sinara-hw/Kasli-SOC/README.md

# Kasli-SOC
Xilinx ZynQ(R)  version of Kasli FPGA controller.

## Design Files

Design files (schematics, PCB layouts, BOMs) can be found at [Kasli-SOC/Releases](https://github.com/sinara-hw/Kasli-SOC/releases).

## Wiki

More information can be found on the [wiki](https://github.com/sinara-hw/Kasli-SOC/wiki).
