sinara-hw/Kasli-SOC/(threads)

Thread 1 (2018-12-02):

Zynq Kasli

dtcallcock, 2018-12-02:
A new Kasli based on the forthcoming v1.2 design, but with a Zynq-7000 series FPGA (2x ARM CPU) instead of an Artix-7 (no hard CPU).

This will allow the proposed [Zynq version of Artiq](https://github.com/m-labs/artiq/issues/1167) to utilise the EEM hardware.

The proposed FPGA is the XC7Z030-3FFG676I.  The reasons for choosing this FPGA (as laid out by @hartytp) are:
- Very similar (same Kintex-7 fabric) to the XC7Z045 FFG900 –2 used on the [Xilinx ZX706 Evaluation Kit](https://www.xilinx.com/products/boards-and-kits/ek-z7-zc706-g.html) that will likely be used for gateware development.
- The CPUs on the 7Z030 go up to maximum 1GHz clock rate available on 7000 series Zynqs.
- Fastest speed grade to ensure we can clock the AXI bus as fast as possible. The thought is that cost sensitive users can stick with the Artix Kasli, and the main user base for Zynq Kasli will be people who don’t mind paying an extra $50 to get the fastest FPGA.
- The design costs + risks will be much lower if we use a Zync model that @gkasprow has used in previous designs. He's used this FPGA before.
- It has enough pins to drive all 12 EEM connectors + WR oscillators

SDRAM would be routed to the ARM subsystem only.  The gateware will still have DMA access based on tests carried out by @cjbe, where he found that:

> I have tested DMA from PL to PS-SDRAM via the HP ports, and indeed it works without any problems, and one gets the advertised bandwidth.

I am working on getting this board funded and would appreciate any input.

Also, is 'Zynq Kasli' a confusing name?  Do we need to dust off our Russian maps and come up with something more unique?

gkasprow, 2019-12-08:
My student will take care of this board very soon. He will post new issues so don't be surprised.

hartytp, 2019-12-29:
XC7Z030-3FFG676 sounds like a good choice for this.

As mentioned before, I'd ideally like to go for 4 SPF + 1 RJ45 on the front panel, copying ethernet from the zc706.

Ram to the PS only.

Other than that, stick as close to the current Kasli 2.0 design as possible.

gkasprow, 2020-01-06:
The schematics are close to completion.
Btw, @sbourdeauducq did you see [this](https://www.electronicproducts.com/Digital_ICs/SoCs_ASICs_ASSPs_MEMS/Microchip_offers_early_access_to_PolarFire_SoC_FPGA.aspx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)

sbourdeauducq, 2020-05-05:
>     * no SD Card

We want a SD card if possible. From experience on ZC706, it might be the least troublesome way to get non-volatile storage on Zynq, and there's the easy "escape hatch" of extracting the SD card and putting it into a $5 USB adapter in case Zynq won't write to it. The PS NOR flash controller is messed up; the only thing that seems to work semi-reliably is a read-only mode where the flash contents are mapped into the CPU memory. We didn't manage to write to the flash at all. There may be some workarounds in some cases like re-routing the flash to GPIO and bit-banging, but it's extra trouble and development time.

filipswit, 2020-05-07:
I'll try to fit it. It looks there is enough space above RAM but only for this kind of socket: https://www.molex.com/molex/products/part-detail/memory_card_socket/0473092651

The white line is the outline of microSD
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

gkasprow, 2020-05-07:
I used a slightly higher version of this Molex connector and managed to fit the BGA chip under the SD card. You can use it as well and rotate the connector if that helps.

sbourdeauducq, 2020-05-08:
How well does this connector hold the SD card?
We'll want to ship systems with the SD card pre-installed, and carriers sometimes handle packages roughly - while they have teams whose job is to find excuses to deny claims. And just normal transportation vibrations tend to dislodge things. So our hardware should be pretty sturdy.

gkasprow, 2020-05-09:
We used these connectors in the production of 8k pieces of LTE routers. There were several issues with these boards but it never happened that SD slipped off.
Here are some photos
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

gkasprow, 2020-05-09:
We used these connectors in the production of 8k pieces of LTE routers. There were several issues with these boards but it never happened that SD slipped off.
Here are some photos
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

jordens, 2020-05-09:
They have the standard spring loaded ratchet locking mechanism, right? There is no way they'd fall out. Get proper packaging and tie down cables properly and make sure fasteners designs are right and tightened properly.

filipswit, 2020-05-16:
Version with SD card is on a repo.

Closed 2020-05-29.

Thread 2 (2020-01-08):

Specification of the module - protection diodes

filipswit, 2020-01-08:
What about protection diodes, about which @gkasprow was recalling in https://github.com/sinara-hw/Kasli-SOC/issues/1#issuecomment-443714668. Should I add them?

gkasprow, 2020-01-08:
No, they are not needed because we assume that modules were already tested prior shipment.

Closed 2020-01-18.

Thread 3 (2020-01-11):

Zynq reset/JTAG fiasco

sbourdeauducq, 2020-01-11:
The Zynq reset and JTAG interface is complicated and temperamental, and in particular we observed the following problems:
* It requires a SRST signal controlled by the JTAG adapter. This signal is a bad idea as reset commands could be delivered over JTAG just fine without the various complications associated with an additional signal. This is apparently done by ARM for power consumption reasons (keep JTAG powered down until the first SRST), but a much better design would have been a level-sensitive "JTAG enable" pin that could be tied high with a jumper in hardware. (In Xilinx's defense, this is a mistake that ARM made)
* A pulse on SRST that is too short makes the ARM cores fall off the JTAG chain (they disappear even if they had been detected just before the short pulse), sometimes until the Zynq chip is power cycled.
* Attempting to use ARM JTAG while one of the ARM cores is stopped breaks the JTAG interface, again, sometimes until a power cycle. Note that stopping an ARM core can be done in firmware; in other words, Zynq is designed in a way that using JTAG at the wrong time depending on what the firmware is doing can put JTAG in an unrecoverable state.

There is a "PS_POR_B" input on Zynq that may or may not be used in lieu of a power cycle. [The technical reference manual says](https://www.xilinx.com/support/documentation/user_guides/ug585-Zynq-7000-TRM.pdf) "This signal resets every register in the device capable of being reset". Trust but verify...

I propose:
* Be very careful about SRST and POR signals on this board. Maybe expose the traces when routing in a way that the board can be easily manually reworked in case of problems.
* Make POR accessible to the debug computer. Putting it on a GPIO expander accessible on one of the I2C buses connected to a FTDI channel sounds like a good idea to me because 1) this FTDI/I2C system worked fine on Kasli 2) we are not exposed to FTDI GPIO problems 3) it makes it harder to accidentally trigger a POR e.g. by using the wrong driver on that FTDI channel.
* Do careful experimentation with POR: put the Zynq into "JTAG broken" states and check that it can always recover with a POR. This can be done on the ZC706 which has POR control on a pushbutton.
* If it turns out that POR doesn't work as documented or if we still don't trust it, also make the Zynq power supply control accessible on I2C.

filipswit, 2020-01-22:
I changed the power sequencing system - https://github.com/sinara-hw/Kasli-SOC/issues/4
So the power supply system should just work.
Now the POR is controlled by supervisor IC and eventually by GPIO. SRST is normally pulled high (unused), optionally you can drive it from GPIO.  Of course during the layout I'll try to put all these traces on external layers.

sbourdeauducq, 2020-01-23:
> SRST is normally pulled high (unused), optionally you can drive it from GPIO.

That's not optional. We **need** to be able to drive it from the JTAG adapter, and to avoid further complications, the SRST layout and polarity must match those of existing common JTAG adapters.

filipswit, 2020-01-26:
Ok. Default mounting will allow it.

Closed 2020-05-29.

Thread 12 (2020-01-12):

add Ethernet chip

gkasprow, 2020-01-12:
add the Marvell Ethernet chip as on ZC706 devkit. It is in CERN lib. It was also used in MARBLE AMC FMC design. It is connected to SoC using RGMII

gkasprow, 2020-01-12:
copy pinout from  ZC706

gkasprow, 2020-01-12:
and add connector with magnetics.

gkasprow, 2020-01-15:
Please use verified schematic from Marble board
https://github.com/BerkeleyLab/Marble

filipswit, 2020-01-22:
Added.
BTW It looks like in Marble is a small bug. VDDO_SEL should be tied low for 2.5V operaion.

Closed 2020-01-22.

Thread 14 (2020-01-12):

IC12 not needed

gkasprow, 2020-01-12:
we have 2V5 on both sides of it

filipswit, 2020-01-18:
'Main_DCXO_OE' and 'Helper_DCXO_OE' are driven from  I2C_expanders -IC24, IC25 (3V3), same as on Kasli. I didn't route it to Zynq just to make as less changes as possible.

Closed 2020-01-19.

Thread 16 (2020-01-12):

missing VREF_DDR and VTT_DDR regulator

gkasprow, 2020-01-12:

Closed 2020-01-18.

Thread 17 (2020-01-12):

use E24 RC

gkasprow, 2020-01-12:
Try to use E24-series RC: DDR termination can be 39R,
LDO and SMPS FB resistors can be calculated out of E24 using [this tool](http://mustcalculate.com/electronics/automaticresistivevoltagedivider.php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)
this limits the BOM count

filipswit, 2020-01-22:
Ok.

Closed 2020-01-22.

Thread 5 (2020-01-12):

TPS7A7200RGW

gkasprow, 2020-01-12:
is there any reason why external divider is used instead of configuration pins?

filipswit, 2020-01-18:
Well..it is easier to adjust voltage after production, but I can change it to configuration pins.

gkasprow, 2020-01-18:
can we have both options? With 0R resistor for example...Once we decide that voltage is OK, we remove feedback resistors

filipswit, 2020-01-18:
Yes. It is more spacious option but it is fine. I just realized that it is probably easier to put 0R to all configuration pins and in case of adjusting add or remove jumper, and it will be with 50 mV accuracy.

gkasprow, 2020-01-19:
in such case just leave as it is.

Closed 2020-01-19.

Thread 6 (2020-01-12):

power budget missing

gkasprow, 2020-01-12:
please add power budget. Use [ADI tool ](https://www.analog.com/en/design-center/design-tools-and-calculators/power-management-tools.html)

filipswit, 2020-01-22:
Added.

Closed 2020-05-29.

Thread 9 (2020-01-12):

P3V3REG

gkasprow, 2020-01-12:
why we have two 3V3 rails?

gkasprow, 2020-01-12:
I assume it is just for the power sequencer chip...

filipswit, 2020-01-19:
Yes, It was for power sequencer, since we not use sequencer it is not needed anymore.

Closed 2020-01-19.

Thread 20 (2020-01-26):

Ethernet connector placement

filipswit, 2020-01-26:
Should it be on front panel? It will cause some changes in SMAin and USB placement.

gkasprow, 2020-01-26:
sure. Not a problem at all. Panel is the easiest part.

Closed 2020-05-29.

Thread 21 (2020-01-29):

Memory bus width

dhslichter, 2020-01-29:
Previous issues with DMA slowness on Kasli (https://github.com/m-labs/artiq/issues/946) suggest that it would be helpful to make the memory bus wider.  If Kasli-SOC is to be a higher-performance sibling of Kasli, it seems we should think about a wider memory bus (more like KC705)?

filipswit, 2020-02-08:
Not sure what we can do with it. On KC705 bus is x64. In Kasli-SOC we connect RAM to PS only, so we have x32.

Closed 2020-05-29.

Thread 22 (2020-04-22):

PCB review

gkasprow, 2020-04-22:
- [x] separate SMPS from oscillators on top layer. The current from SMPS flows through the R40
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. It's better to use diamond-type copper balancing on top and bottom.
- [x] remove acute angles
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
- [x] use symmetrical amount of copper on component pads. Either use thermals on both vias or solid copper on both pads.
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
- [x] GTPs are too close
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
- [x] perform PI analysis in Altium, it has nice PDN tool
- [x] no need to use polygon as VREF line. It breaks the SI for DDR lines on Mid8. Single trace is good enough
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
- [x] separate the vias - now they break vertically all planes and create the loop. Simply move every second via to the right.
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
- [x] move the power plane to the left so it does not cross the MGT lines
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
- [x] add a note to the DIP switch
- [x] add FPGA heatsink 3D model
- [x] add MCX and SMA connector functions
- [x] add IC designators

Closed 2020-05-29.

Thread 23 (2020-05-10):

SDRAM reference?

sbourdeauducq, 2020-05-10:
Is the SDRAM configuration an exact copy of a Xilinx development kit, and which one?
Getting the PS SDRAM controller to work is rather difficult, so it would be good to simply reuse something that is known to work (also we could simply run the existing FSBL for a quick test of the board) and for which the correct PS register values can be looked up.

filipswit, 2020-05-15:
It's connected without any pin swapping.

sbourdeauducq, 2020-05-16:
What about the SDRAM chip P/N including timing, number of rows/columns, etc.

filipswit, 2020-05-16:
I've used: MT41K256M16TW-107:P

sbourdeauducq, 2020-05-17:
Is there a Zynq Xilinx kit with this exact chip?

filipswit, 2020-05-20:
I've found only some chinese kits: qmtech zynq7000 and Lychee HEX ZYNQ702.

sbourdeauducq, 2020-05-21:
Could we use a SDRAM system that is an exact copy of a better-known kit? Is there a reason not to?

sbourdeauducq, 2020-05-21:
For example, Cora Z7-10. Not that we have managed to get the SDRAM to behave itself on this board without the Xilinx junk libraries (we have only done so on the ZC706, on the Cora there is typical Zynq behavior) - but at least we can use the latter as a workaround.

filipswit, 2020-05-21:
Well, SDRAM from Cora -  MT41K256M16HA-125:E looks fine for me.

sbourdeauducq, 2020-05-23:
OK.

Closed 2020-05-23.

Thread 24 (2020-07-22):

HDL verification

gkasprow, 2020-07-22:
@sbourdeauducq did you look at SoC pins assignments? We want to produce it pretty soon
@filipswit did you run the SI-DDR test after routing?

filipswit, 2020-07-22:
nope, I didn't.

sbourdeauducq, 2020-07-23:
> @sbourdeauducq did you look at SoC pins assignments?

No. We are scrambling to get things to work on the ZC706 before the deadline, lots of difficult problems appeared when we tried to run non-trivial kernels.

sbourdeauducq, 2020-07-23:
Could you publish PDF schematics (we don't have Windows machines or Altium, and the online viewer is a bit unwieldy), and a machine-readable version of the FPGA pin assignments?

filipswit, 2020-07-23:
Sch:
https://github.com/sinara-hw/Kasli-SOC/tree/master/PDF

sbourdeauducq, 2020-07-23:
Thx

sbourdeauducq, 2020-07-23:
What is the purpose of the PL watchdog? The PL is generally quite well-behaved, it's the PS that is often troublesome.

sbourdeauducq, 2020-07-23:
Table on Sheet 7 says " 1 | 1 => SD Card (not on board)", but now we have a SD card.

sbourdeauducq, 2020-07-23:
Clock-capable EEM pins (indexed 0) must go to CC pins!
The clock rules on the PL are the same as regular 7-series FPGAs.

marmeladapk, 2020-07-23:
@filipswit It would be better to tag a commit and make a (preliminary) release and post PDF there. It won't clutter up the repository (which can significantly increase in size due to many binary files) as PDF is an output file not a source. We follow this approach in other Sinara repositories.

sbourdeauducq, 2020-07-23:
I suggest connecting RGMII to the PS (MIO). We have a driver for it so we might as well use it; and other Zynq code (e.g. some people love embedded Linux) also typically expects the PS Ethernet controller.
What's the idea with Ethernet anyway? Are we going to use primarily the RJ45 jack (with PS MAC) or the SFP (with transceiver and PL MAC)?

hartytp, 2020-07-23:
> What's the idea with Ethernet anyway? Are we going to use primarily the RJ45 jack (with PS MAC) or the SFP (with transceiver and PL MAC)?

I'd love to have Ethernet on the RJ45 in addition to the standard 4 SFPs.

As an example use case: it's been an ambition of ours for a while to have a feature which lets us stream out diagnostic data via ethernet. e.g. ADC traces to implement scope-like functionality. Would be great to have this on satellites while still maintaining our 3 downstream DRTIO ports.

sbourdeauducq, 2020-07-23:
I2C can go to the PS so we can autodetect the cards without any gateware programmed (@jordens might like this).
It would be fun to run yosys and prjxray on the PS and have the card build its own gateware :)

Many of the other GPIO signals currently in PL bank 13 (fan, pushbutton, error LED, maybe some of the user LEDs, etc.) can go to the PS as well, but definitely not the WRPLL I2C. The Zynq architecture is PS-centric (for better or worse, IMO mostly the latter), and the card should reflect that.

Note: if we need to free resources, the QSPI NOR flash can go. The SD card works well here (both r+w) and we don't currently plan to use the flash at all.

gkasprow, 2020-07-23:
@filipswit Moreover, EEMx signals should be in the same bank. Remember when changing CC pins assignments.

sbourdeauducq, 2020-07-23:
Why do we have an EEPROM (IC8) with a dedicated I2C bus?
Do we need the DS2411R identifier device when we can get I2C EEPROMs with a unique ID burned in instead?

gkasprow, 2020-07-23:
@sbourdeauducq Ethernet is routed to PL for flexibility. The embedded MAC can talk to it via EMIO easily.

gkasprow, 2020-07-23:
I2C goes to PL for flexibility. We had issues with PS I2C reliability and had to use IPcore instead. But it was an issue with early silicon versions.

sbourdeauducq, 2020-07-23:
> Ethernet is routed to PL for flexibility. The embedded MAC can talk to it via EMIO easily.

It's more a compromise than "flexibility": This requires the gateware to be programmed for Ethernet to work, and then we cannot download gateware from the network during boot, for example.
Also, I am worried about timing issues with the gateware routing delays between EMIO and PL I/O pins.

> We had issues with PS I2C reliability

PS peripherals are generally garbage indeed, but in the case of I2C I think we can use the MIO in GPIO mode and bit-bang from software. That should work around the idiocy built into the PS I2C controller. If you're worried we could demonstrate that on a devkit.

sbourdeauducq, 2020-07-23:
I'm a little skeptical of the analog hack that involves AC coupling of the fan PWM signal. Has this been tested before?

sbourdeauducq, 2020-07-23:
Don't we have the same I2C bug with the FTDI chip that caused contention on Kasli v2?

sbourdeauducq, 2020-07-23:
The SRST signal ***absolutely*** needs to go on the FTDI chip GPIO directly, with a configuration that is ***strictly identical to a known-good programming adapter***. Controlling it via FTDI I2C, switches and expanders in OpenOCD (or worse, Vivado, which already crashes every 15min when connected to a Zynq device) will be an absolute disaster and result in insane levels of frustration.

For example, SRST control mostly works with the Olimex ARM-USB-TINY-H, but I could not get it to work with the internal JTAG module of the ZC706.

Note that even with SRST control, there are still plenty of PS JTAG bugs and weird hardware states that require a power cycle to get out of.

sbourdeauducq, 2020-07-23:
And, someone should check, but I think that if you do not send a SRST *pulse* (constant level is not sufficient) then the ARM cores do not appear on the JTAG chain, only the PL does. So this signal is really important.

sbourdeauducq, 2020-07-23:
SRST also needs to be exposed on J8.

sbourdeauducq, 2020-07-23:
Nitpick: do we need a "general purpose pushbutton"? Kasli doesn't have one and there's no use case for it AFAIK.

sbourdeauducq, 2020-07-23:
> As an example use case: it's been an ambition of ours for a while to have a feature which lets us stream out diagnostic data via ethernet. e.g. ADC traces to implement scope-like functionality. Would be great to have this on satellites while still maintaining our 3 downstream DRTIO ports.

What about using the DRTIO aux channel for this?

hartytp, 2020-07-23:
> What about using the DRTIO aux channel for this?

@dnadlinger but I believe the idea was to keep things distributed to avoid bottlenecks of doing everything through the master

dnadlinger, 2020-07-23:
I recently discussed this with @pmldrmota, as he is looking into this with our summer student Miray. Basically, using the aux channel would be the preferred solution if we can get the "relay" bandwidth on the root of the tree, i.e. the core device, high enough (some dozen Mb/s to Ethernet) without interfering with kernel RPCs too much.

If that turns out to be hard (which it might well on or1k), putting Ethernet on the satellites would be a "scalable" fallback option.

filipswit, 2020-07-26:
> What is the purpose of the PL watchdog? The PL is generally quite well-behaved, it's the PS that is often troublesome.

I can remove it or connect to PS

> Do we need the DS2411R identifier device when we can get I2C EEPROMs with a unique ID burned in instead?

I can remove it

> I'm a little skeptical of the analog hack that involves AC coupling of the fan PWM signal. Has this been tested before?

It's a copy from Kasli, so I assume it works.

> Don't we have the same I2C bug with the FTDI chip that caused contention on Kasli v2?

What kind of bug?

> he SRST signal absolutely needs to go on the FTDI chip GPIO directly,

Ok will swap it from I2C expander to FTDI GPIO.

> Nitpick: do we need a "general purpose pushbutton"? Kasli doesn't have one and there's no use case for it AFAIK.

I thought might be useful. Will be removed.

sbourdeauducq, 2020-07-26:
> > What is the purpose of the PL watchdog? The PL is generally quite well-behaved, it's the PS that is often troublesome.
>
> I can remove it or connect to PS

There are some PS states which are unrecoverable without a power cycle (they include JTAG breakage). I don't know if using the POR signal instead of a power cycle would work. Maybe it is worth keeping the watchdog as an option that can pulse POR, with an easy option to disable it (e.g. jumper or solder bridge) so it does not get in the way of early development and/or can be permanently disabled if it causes trouble.
Also, keep in mind that loading a program into the Zynq from JTAG (PS+PL) takes dozens of seconds during which the Zynq chip is frozen, and if you pulse POR during that time then it won't work. Booting it from the SD card is also not instantaneous, and a POR pulse will interrupt the boot process. Any watchdog circuit must be designed accordingly.

> > Do we need the DS2411R identifier device when we can get I2C EEPROMs with a unique ID burned in instead?
>
> I can remove it

OK.

> > I'm a little skeptical of the analog hack that involves AC coupling of the fan PWM signal. Has this been tested before?
>
> It's a copy from Kasli, so I assume it works.

AFAIK nobody tested it.

> > Don't we have the same I2C bug with the FTDI chip that caused contention on Kasli v2?
>
> What kind of bug?

https://github.com/sinara-hw/Kasli/issues/78

> > he SRST signal absolutely needs to go on the FTDI chip GPIO directly,
>
> Ok will swap it from I2C expander to FTDI GPIO.

Make sure this matches a layout that OpenOCD and - if possible - Vivado already supports.

marmeladapk, 2020-07-26:
> AFAIK nobody tested it.

We tested it at CTI during Kasli v2.0 tests. It works fine.

niedz., 26 lip 2020, 13:10 użytkownik Sébastien Bourdeauducq <
notifications@github.com> napisał:

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

filipswit, 2020-08-03:
Schematics and actual pin assignment:

[Kasli-SOC.PDF](https://github.com/sinara-hw/Kasli-SOC/files/5018408/Kasli-SOC.PDF)

[Kasli-SOC.zip](https://github.com/sinara-hw/Kasli-SOC/files/5018413/Kasli-SOC.zip)

sbourdeauducq, 2020-08-04:
Which OpenOCD cable file should I use to set up SRST?

sbourdeauducq, 2020-08-04:
How is the watchdog getting disabled during JTAG programming (which takes more than 700ms)?
The POR pulse does not need to be as long as 1s.
What is the purpose of C75? Glitch filtering? I wonder if slow rising edges on POR_B are good. And glitch filtering may not be necessary. The TRM states: "The PS_POR_B reset pin is held Low until all PS power supplies are at their required voltage levels and PS_CLK is active. It can be asynchronously asserted and is internally synchronized and filtered. The  filter prevents High-going glitches from entering the PS while the signal is intended to be held Low. It does not filter Low-going glitches when the signal is intended to be held high. Any Low-going glitch that is detected causes an immediate reset of the device."

If there are too many issues with this watchdog chip and associated circuitry (IC29A, IC29B, C75...), we might as well remove them, simply keeping IC30. Also, remove PB2 (oftentimes, ARTIQ boards are used remotely without physical access to pushbuttons) and connect I2C_exp_POR to MR# of IC30.

I suggest connecting I2C_exp_POR to a FTDI GPIO directly. The Zynq may lock up the I2C bus (all it takes is holding SCL or SDA low), which is a common situation, and then we can't POR it to recover control.
Considering the state of FTDI chips and associated software, this requires careful prior testing:
* the GPIO is actually working with the FTDI chip configured as intended on this board (JTAG, I2C, UART)
* toggling the GPIO does not break JTAG, UART, or I2C. FTDI GPIO controllers are extremely buggy and there are lots of surprises like that.
* using OpenOCD with default cable files does not trigger POR
* plugging the USB cable with the default (UART) driver attaching does not trigger POR

IC30 is only monitoring 3.3V, and 3.3V comes before VCCDDR according to the table on page 14. Isn't VCCDDR a PS supply?

I still think more signals should be routed to the MIO instead of the PL, in particular the RGMII ones where timing is critical and where we may want to boot from the network including the PL. PL Ethernet, if required, can still be done with SFP and transceiver. Also, have you copied *exactly* the Ethernet circuit of a devkit? Is the PHY functional immediately after power up without having to fiddle with MDIO?

What is the idea with the "internal" I2C bus?

filipswit, 2020-08-04:
When we connect PS_POR to IC30 MR#, we can skip IC29 and simplify it a little.

Is there any difference to which FTDI output I connect PS_POR?

From UG: "The PS_POR_B input is required to be asserted to GND during the power-on sequence
until VCCPINT, VCCPAUX and VCCO_MIO0 have reached minimum operating levels" so P3V3 is last rising PS supply.

Actually I can connect tems sensors to SHARED_I2C. IC8 can be removed as well, I just havent noticed there is IC5 eeprom on MUX sheet.

sbourdeauducq, 2020-08-05:
> Is there any difference to which FTDI output I connect PS_POR?

As long as the four tests above are OK, no.

sbourdeauducq, 2020-08-07:
> PS peripherals are generally garbage indeed, but in the case of I2C I think we can use the MIO in GPIO mode and bit-bang from software.

It works:
https://git.m-labs.hk/M-Labs/zynq-rs/pulls/58

Please connect I2C (and other things) to the PS. As long as there is no case for gateware acceleration/control, things should go to the PS by default.

filipswit, 2020-08-12:
I made above changes. @sbourdeauducq I2C and interrupts, and switch reset are routed to PS now.
Below are actual sch and pin assignment. If everything is fine, during weekend I will put final layout on repo.
[Kasli-SOC.zip](https://github.com/sinara-hw/Kasli-SOC/files/5065510/Kasli-SOC.zip)

[Kasli-SOC.PDF](https://github.com/sinara-hw/Kasli-SOC/files/5065494/Kasli-SOC.PDF)

sbourdeauducq, 2020-08-13:
> Which OpenOCD cable file should I use to set up SRST?

What about this question?

>  Considering the state of FTDI chips and associated software, this requires careful prior testing:

Have you done these tests?

RGMII should still go to the PS.

I also recommend connecting at least LED_ERR to the PS so that errors that occur before PL startup can be reported on the front panel as well.

Should there be pullups on I2C_SW_RESET so that the I2C switches are automatically reset when the Zynq is reset (please check if a simple pullup resistor would work: timing, state of MIO during reset)? Then the other I2C_SW_RESET line to the FTDI chip can perhaps be removed, since we could POR the Zynq to recover from a stuck I2C bus situation.

filipswit, 2020-08-14:
> Which OpenOCD cable file should I use to set up SRST?

Sorry I've never used OpenOCD. I cant figure what are 'cable files'.

I connected it with this connecion list:
− RXD(5) - TDI
− TXD(1) - TCK
− RTS(3) - TDO
− CTS(11) - TMS
− DTR(2) - TRST
− DCD(10) - SRST

from http://openocd.org/doc/pdf/openocd.pdf

> Considering the state of FTDI chips and associated software, this requires careful prior testing:

Have you done these tests?

I don't have possibilities to make these tests.

> Should there be pullups on I2C_SW_RESET so that the I2C switches are automatically reset when the Zynq is reset (please check if a simple pullup resistor would work: timing, state of MIO during reset)? Then the other I2C_SW_RESET line to the FTDI chip can perhaps be removed, since we could POR the Zynq to recover from a stuck I2C bus situation.

I will add PU/PD with default mounted PU and leave I2C_SW_RESET line to the FTDI as is, when will be not needed will mark it as not mounted in future.

Because we connect Ethernet to PS, it will cause some more layout rework with LVDS and supplies and probabbly something more. @sbourdeauducq so now, I can connect some more stuff to PS, could you please point which exactly signals you would like to be conneccted to PS instead of PL.

sbourdeauducq, 2020-08-15:
> Sorry I've never used OpenOCD. I cant figure what are 'cable files'.

> I don't have possibilities to make these tests.

Someone ought to figure this out, study it in detail, and run the tests carefully before board fabrication. Both the FTDI chip and the Zynq JTAG/reset interface are obnoxious crap, which, combined together, really have a lot of potential for frustrating problems if we are not very careful.
Vivado support is also desirable, if possible at all without breaking OpenOCD. For example the built-in JTAG adapter of ZC706 works with Vivado as far as Zynq stuff works with Vivado, but is very unreliable with OpenOCD due to obscure SRST-related problems. It may be a good idea to have someone spend time on understanding why this is the case. I just wanted to my code to run so I used an external Olimex cable instead (incompatible with Vivado), and "only" spent two days on this problem.
I do not currently have more time for these onerous tasks, but not doing it right now is just kicking the can down the road and making the problem worse since it will then involve PCB rework and/or fabrication of adapters to connect external JTAG cables to the broken internal programming system. If you want to go that route, please make the JTAG, POR, and SRST signals easy to disconnect and rewire to an external adapter (for JTAG and SRST, ARM-USB-TINY-H works mostly correctly on ZC706).

> Because we connect Ethernet to PS, it will cause some more layout rework with LVDS and supplies and probabbly something more.

If you want some simplification you can drop both SPI flash chips - we don't plan to use it, the SD card does the job.

> @sbourdeauducq so now, I can connect some more stuff to PS, could you please point which exactly signals you would like to be conneccted to PS instead of PL.

* I2C (except WRPLL): definitely PS
* GPIO_INTx, I2C_SW_RESET: same as above
* RGMII, MDIO, PHY_RSTn: definitely PS
* Fan PWM: not sure about this one since I don't know if the PS PWM controller works correctly (if I did I would say move to PS), and wasting CPU cycles on toggling the fan GPIO sounds annoying. Maybe just leave it to PL.
* DDBUS: good idea to leave on PL since we can use it e.g. with Microscope, but maybe rename it to UART_PL (and the other one UART_PS).
* LEDs: ERROR LED should go to PS as I said, for LEDs in general maybe a mix of PS/PL is good since LEDs are sometimes useful to debug/test simple gateware.

Why are there still two general purpose I2C buses (SDA_int/SCL_int and I2C_2V5_SW_SDA/I2C_2V5_SW_SCL)?

sbourdeauducq, 2020-08-29:
Are you leaving the 1-wire ID thing? It's still on the latest schematics.

gkasprow, 2020-08-29:
The less various interfaces the better. More useful are ID chips with MAC address

filipswit, 2020-08-29:
@sbourdeauducq  are you sure you are watching the latest files?

sbourdeauducq, 2020-08-29:
No, my mistake. But please remove https://github.com/sinara-hw/Kasli-SOC/tree/master/PDF

filipswit, 2020-08-29:
I will do it with next repo update.

filipswit, 2020-09-20:
SPI Flash was removed due to routing problems.
I added 2.54 mm jumper for POR and SRST signals. I hope that this will be fine for debugging.
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

[Kasli-SOC.PDF](https://github.com/sinara-hw/Kasli-SOC/files/5251952/Kasli-SOC.PDF)

[Kasli-SOC_20200920.zip](https://github.com/sinara-hw/Kasli-SOC/files/5251953/Kasli-SOC_20200920.zip)

sbourdeauducq, 2020-09-21:
For POR I would put the jumper *before* the supervisory IC. The manual is clear that POR should be asserted until supplies are stable, so removing the jumper would otherwise always cause problems.

The issue with these signals really comes from:
1. crappy FTDI chips
2. crappy drivers
3. crappy JTAG software
4. [stupid attitude from Xilinx](https://www.xilinx.com/support/answers/68889.html)

sbourdeauducq, 2020-09-30:
Anyway, this solution forgoes Vivado hardware manager support. Only dissecting Xilinx/Digilent adapters for supported POR/SRST configurations, putting a Xilinx compatible JTAG header, or putting one of those silly Digilent FTDI modules would enable it.
I hate Vivado and the current solution with probably-working FTDI GPIOs and jumpers for easy debugging/workarounds would be somewhat okay with me personally, but it will cause problems if you/others want to develop with the official Xilinx toolflow.

sbourdeauducq, 2020-09-30:
If I understand correctly, the IC42 inverter would fix the equivalent of https://github.com/sinara-hw/Kasli/issues/78.
I'm still not a fan of multimastering I2C and would prefer a "I2C proxy firmware" that talks over UART (that's easily developed, and loaded by JTAG into the Zynq OCM). Do we keep the FTDI-I2C at all (@jordens)?

jordens, 2020-09-30:
Yes

hartytp, 2020-09-30:
@sbourdeauducq can we move this to its own issue to make following the conversation easier?

> Do we keep the FTDI-I2C at all (@jordens)?

The USB-I2C interface provides useful functionality which I'd be sad to loose. What would you replace it with? Assuming the issue is now fixed on Kasli, I struggle to see a good reason (i.e. not just aesthetics) to throw that away.

sbourdeauducq, 2020-09-30:
As I mentioned: replace it with a I2C proxy firmware.
The hardware does not have problems but the ARTIQ I2C firmware implementation does not support multimastering, and likely other implementations such as libftdi do not support it well either. Multimastering is complex and fragile and implementing it correctly is harder than loading proxy firmware/gateware.
You will hit bugs if you try to access the I2C bus while ARTIQ is running and attempting to use it at the same time.

sbourdeauducq, 2020-09-30:
Anyway as long as the hardware doesn't have problems, I don't really care about this issue, and we can always DNP the related components later.

sbourdeauducq, 2021-02-16:
We have firmware now:
https://nixbld.m-labs.hk/build/129246
https://git.m-labs.hk/M-Labs/artiq-zynq/src/branch/master/demo.json
(Still a few things missing like Si5324 programming but that shouldn't take long)

Closed 2021-06-21.

Thread 25 (2020-08-06):

RAM: Copy ZC706 exactly

hartytp, 2020-08-06:
Please can we exactly copy the ram from the ZC706 board?

filipswit, 2020-08-07:
The exact copy is unbuyable. Current chip is used in Cora Z7-10 - #23

hartytp, 2020-08-07:
Thanks @filipswit. "You can't buy it" is a pretty good reason not to use the chip on the ZC706. What's the most similar replacement? I have a preference for lots of ram with a nice wide bus here... @sbourdeauducq thoughts?

filipswit, 2020-08-08:
In general this memory family looks to be little available: https://pl.mouser.com/Search/Refine?Keyword=MT41J256M8&Ns=Access+Time%7C1

The family in FBGA-96 package looks to be more popular: https://pl.mouser.com/_/?keyword=MT41K256M16. We can easily use DDR3 or DDR3L chips.

Another thing why I don't like this idea is that they are in different package so the RAM will need to be rerouted.

hartytp, 2020-08-10:
@sbourdeauducq what's your preference here? Again, reiterating my preference for a large/wide RAM on Kasli-Soc...

sbourdeauducq, 2020-08-10:
The RAM on Kasli-SoC is 32-bit no matter what - or did I miss out something?
If the ZC706 RAM cannot be purchased I don't think there's a better option than "try the RAM that's on Cora-Z7, but 32-bit instead of 16-bit, and see what happens".

sbourdeauducq, 2020-08-10:
Does the memory capacity at the level of commercial DRAMs (hundreds of MB) really matter?

hartytp, 2020-08-10:
> Does the memory capacity at the level of commercial DRAMs (hundreds of MB) really matter?

IIRC @dnadlinger has had issues overflowing the memory on Kasli

dhslichter, 2020-08-11:
> IIRC @dnadlinger has had issues overflowing the memory on Kasli

Ouch!  How?

dnadlinger, 2020-08-11:
> Ouch! How?

There was a memory leak at some point, but the bigger issue was with DMA, which currently panics the comms CPU if you run out of space, which can happen quite easily as sequences persist across experiments (and we currently don't have an API to just erase all of them in cases where persistence is not wanted).

I haven't checked how much RAM we are actually using at any one time, or done the math on how that number would change for e.g. long transport sequences with a few Fastinos.

sbourdeauducq, 2021-05-28:
RAM working correctly so far on prototype.

Closed 2021-05-28.

Thread 26 (2020-08-06):

Ethernet: copy ZC706

hartytp, 2020-08-06:
Please can we make sure that the ethernet is an exact copy of the ZC706?

filipswit, 2020-08-07:
Ok, I may change it to 88E1116.

filipswit, 2020-08-08:
How should I set configuration pins Config[0..3]?

hartytp, 2020-08-10:
^ @sbourdeauducq

sbourdeauducq, 2020-08-10:
The default jumper settings for ZC706 work here. Beyond that I don't particularly know.

gkasprow, 2020-08-12:
what's wrong with 88E1512? it's already used in Sayma and Marble board and it works with Litex.

sbourdeauducq, 2020-08-13:
It's probably fine, just not tested with Zynq and AFAIK not tested on Sayma either (IIRC this was replaced on v2.0, and never used there, though this will probably change soon since we're still having problems with the GTH)...
To put it politely, the LiteX policy is to be optimistic about what "works" with it. GTH Ethernet also "works" with LiteX.

sbourdeauducq, 2020-08-13:
Does it need any MDIO transactions before it operates or does it power up with functional default settings?

gkasprow, 2020-08-13:
Yes, AFAIR it needs one transaction to set up the interface to RJ45 mode. It's quite a new chip and supports several modes like IEEE1588 and SyncE. It's used in several dev boards as well. And it has an official open datasheet. The 88E1116 is old and power-hungry.
It also supports SFP modules directly. But I do not insist very much on this solution.

sbourdeauducq, 2020-08-13:
Okay, we have code for MDIO on Zynq but I need to check if it works, which can be done on ZC706. As you have seen with I2C even simple PS peripherals can be troublesome...

sbourdeauducq, 2020-08-14:
It works. So, in theory, adding the 88E1512 init should be inexpensive. Please still connect all Ethernet signals to the PS directly, though.

gkasprow, 2020-08-14:
yes, PS connectivity is good idea. Use same pins as on the devkit. Then it will work without the bitstream. If we want PL access to Ethernet, will use transceivers and SFP.

filipswit, 2020-08-14:
And revert 88E1512, right?

gkasprow, 2020-08-14:
@filipswit do what is easier for you, in terms of routing

sbourdeauducq, 2020-08-15:
>  Then it will work without the bitstream

And we won't have to worry about meeting timing on RGMII.

filipswit, 2020-09-20:
I placed 88E1512 and connected it directly to PS.

Closed 2021-05-28.

Thread 27 (2020-08-11):

Align clocking tree to DI/OT

jordens, 2020-08-11:
https://github.com/sinara-hw/meta/issues/56#issuecomment-670604266

filipswit, 2020-08-15:
@gkasprow how about this? Do we make changes in clocking in this revision or in future?

hartytp, 2020-08-18:
@jordens AFAICT (but correct me if I'm wrong) the only part of that post that's relevant here is this bit

> Clocking: IMO Kasli-SoC should use the DI/OT clocking tree (add 4 MMCX). It support all options (WR CR with VCXO, DCXO, and Si5x-based recovery).

Could you sketch out (phone snap of a paper sketch completely fine) what solution you want (eliminates room for confusion between people comparing schematics manually).

> I'd like profit from the CERN involvement (review, development, characterization, testing, volume, cost). Pretty sure that Kasli-SoC will not profit much from that.

If I'm reading you correctly, the motivation for these changes on the DI/OT card was to make something that's compatible with both ARTIQ and CERN so that we can benefit from CERN's involvement. That makes sense in that context, but CERN are not going to use Kasli-SoC whatever we do with the clocking, so the motivation for applying these changes here is unclear to me.

Why not stick with the clock tree on Kasli v2.0 which (other than the WR) is known to work for our purposes? Why add other components which don't have any clear users?

Could you articulate the benefit from implementing these changes on Kasli-SoC as opposed to keeping Kasli-SoC as close as possible to "Kasli v2.0 with Zynq" and converging on the CERN designs in the DI/OT board?

Thread 28 (2020-08-11):

prepare for cPCIS mechanics

jordens, 2020-08-11:
Would be great to have a future cPCIS port be easy without too much layout changes.

* There seems to be a natural superset of the cPCIS mechanics and out old 3U mechanics.
* I'd take the cPCIS mechanical template (handle, ejector, ESD strips, keepout, backplane connector area etc) and adhere to that.
* Then, when doing non-cPCI panels and mechanics, just don't cut the PCB.
* Put the IDC connectors close (!) together in bottom right corner and right edge. Make the layout switch from IDC to backplane connector easy.

gkasprow, 2020-08-12:
@jordens my concept was to follow the Kasli layout and use Kasli/Kasli SoC to CPCIs adapter. It will give us transition time to support both ribbon and CPCIS users. Some day we will switch to CPCIS with all modules.
The KasliSoc is already route, Anyway, there will be a second revision, so I'd produce it as it is (with only minor changes)

Thread 29 (2020-09-03):

JTAG and reset validation

sbourdeauducq, 2020-09-03:
* identify or write an OpenOCD cable file that can be used with the FTDI chip as connected on this board.
* test that the POR GPIO is actually working with the FTDI chip configured as intended on this board (JTAG, I2C, UART).
* test that toggling the POR or SRST GPIO does not break JTAG, UART, or I2C. FTDI GPIO controllers are extremely buggy and there are lots of surprises like that.
* test that using OpenOCD with the cable files does not trigger POR.
* test that plugging the USB cable with the default (UART) driver attaching does not trigger POR or SRST.

This should be done before board production.

hartytp, 2020-09-03:
@sbourdeauducq to check I understand the situation here...

The ZC706 has two JTAG headers and a [digilent USB JTAG module](https://store.digilentinc.com/jtag-smt2-surface-mount-programming-module/). Am I right in thinking that:
- you started using the digilent USB JTAG module but didn't get that to work
- so you switched to using an Olimex USB JTAG adapter going into one of the headers
- the Olimex programmer works reliably but is less convenient than the USB solution

The current Kasli-SoC schematic has a FT4232H (like Kasli-Artix) for JTAG instead of the digilent module as well as a standard 2x7 header.

Am I right in thinking that the 2x7 header combined with the Olimex cable work reliably since it's the same configuration you've already tested? So, we have that as a "known good" fall back?

Is your concern that (due to implementation of the Zynq JTAG interface) the FTDI chip might be a pain to get working? Or are you worried that we might just not be able to get it to work at all?

Are you suggesting that we should get this working prior to sending the prototypes off to manufacture? If so, what hardware configuration do you want to see used in the tests? Or, since we have the Olimex adapter as fallback, are you suggesting we keep the hardware as is for now, but make sure to allocate resources for testing/development once the hardware arrives?

hartytp, 2020-09-03:
e.g. are you suggesting that someone should take a FT4232H eval module and wire it up to the JTAG header on a KC706 at this stage?

It sounds like the POR/GPIO tests you want to see can all be done using a FT4232H eval board only, right?

sbourdeauducq, 2020-09-03:
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

Correct.

>  are you suggesting that someone should take a FT4232H eval module and wire it up to the JTAG header on a KC706 at this stage?

That would be a very good thing to do, yes. Maybe also POR with a bit of soldering.

hartytp, 2020-09-03:
@gkasprow what do you think about this? Could one of your students wire up a FT4232H eval module to a Zynq evaluation board like a ZC706 and confirm that they can flash the FPGA from openocd?

sbourdeauducq, 2020-09-03:
Also, we should try to use a layout that is compatible with Vivado. And also check that Vivado won't toggle POR. But that's low importance.

sbourdeauducq, 2020-09-03:
>  confirm that they can flash the FPGA from openocd?

Run it a couple hundred times, many Zynq JTAG bugs are intermittent.

hartytp, 2020-09-03:
> Run it a couple hundred times, many Zynq JTAG bugs are intermittent.

Ok. Your initial issue description didn't make it clear what test you wanted (hardware configuration, what should be done, etc) and what the criteria for success is. So, we're talking about having a loop that repeatedly flashes a binary via openocd without openocd raising an error?

gkasprow, 2020-09-03:
That's interesting. I didn't manage to enter the debug session with a standard red Xilinx programmer, while Vivado worked fine with it.
HS2 from Digilent works fine in both cases. However, I tried it with ZynQ US+.
ZC706 uses also Digilent module based on FT2232
HS2 is just FT2232. The only difference is the EEPROM content.

gkasprow, 2020-09-03:
Yet another option could be using direct access to the PS JTAG over MIO pins. FT4232 has two JTAG controllers that could be run independently

sbourdeauducq, 2020-09-04:
> That's interesting. I didn't manage to enter the debug session with a standard red Xilinx programmer,

There's plenty of "interesting" behavior like that with JTAG on Zynq, which is why we must be careful.

> However, I tried it with ZynQ US+.

US+ has a different ARM core and JTAG system, so tests on US+ are mostly irrelevant to Kasli-SoC.

> ZC706 uses also Digilent module based on FT2232
> HS2 is just FT2232. The only difference is the EEPROM content.

Right. That's why it may be interesting to try to stay compatible with Vivado on Kasli-SoC.

> Yet another option could be using direct access to the PS JTAG over MIO pins.

That second JTAG port is enabled only after software has turned it on, so it creates a chicken-and-egg situation. As far as I know, Xilinx added that second port only because a number of electronics engineers love to use legacy debuggers for ARM that break if there's something else on the chain. This also means we could not use that port to debug the PL. And there is no indication that it would work better than the main JTAG that has PS+PL.

sbourdeauducq, 2020-09-07:
One data point: on the Ultra96 JTAG board (AES-ACC-U96-JTAG), Avnet are using a FT2232H with both SRST and POR on GPIOs. So it seems possible to do that. Maybe we can try that JTAG board with OpenOCD and the ZC706 and see if it works.

sbourdeauducq, 2020-09-07:
Gave it a quick try, got the standard fare "Error: JTAG scan chain interrogation failed: all ones", so someone does need to spend a week on that thing.

sbourdeauducq, 2020-09-07:
Also, plugging the USB connector (without running anything on the computer) into the AES-ACC-U96-JTAG resets the Zynq, so this pod is an example of what not to do...

Closed 2021-06-21.

Thread 31 (2020-11-10):

compare with kasli 2.1

hartytp, 2020-11-10:
Let's check that all relevant changes from Kasli >= 2.0 have been included in this

gkasprow, 2021-01-05:
I recently added 6pins spaced by 2.54mm to support 4 direct IOs

filipswit, 2021-01-06:
Ok, I can fit additional 4 IOs.
I've noticed that SMA input is biased to 1.25V after balun instead of AC coupled.
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

gkasprow, 2021-01-06:
I already added the IOs. The FPGA actually needs DC coupling and it's good to have external 100Ohm matching.

filipswit, 2021-01-06:
But last commit is mine and is without it.

gkasprow, 2021-01-06:
I didn't do the commit yet so don't modify your project

filipswit, 2021-01-06:
I change fan connector to be with key.

Should I add capacitors before and after EMI filter FL*?

Thread 33 (2021-01-14):

speed grade

sbourdeauducq, 2021-01-14:
The [initial proposal](https://github.com/sinara-hw/Kasli-SOC/issues/1) called for the "fastest speed grade", yet the schematics has speed grade 2.

There are quite some difference in PS performance between the grades. Can we get speed grade 3?

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

gkasprow, 2021-01-14:
I think you can specify which SG you want during ordering the board.

sbourdeauducq, 2021-01-14:
Certainly, but we're not going to support more than one speed grade in ARTIQ, and that should be speed grade 3.

filipswit, 2021-02-16:
I've replaced Zynq symbol to: XC7Z030-3FFG676E

Closed 2021-06-21.

Thread 37 (2021-01-18):

Increase P3V6_CLK voltage

marmeladapk, 2021-01-18:
LT3045 has lousy PSRR with low difference between input and output voltage.

filipswit, 2021-02-14:
Increased to 4.55V

Closed 2021-02-14.

Thread 44 (2021-01-20):

Add additional filtering on P12V0 input to buck

marmeladapk, 2021-01-20:
https://github.com/sinara-hw/Kasli/issues/66

Closed 2021-02-14.

Thread 45 (2021-01-22):

Change project settings for pin swapping

marmeladapk, 2021-01-22:
Uncheck "changing schematic pins".

Closed 2021-02-14.

Thread 49 (2021-02-22):

Rear power connector

kaolpr, 2021-02-22:
Is the rear power connector purposely different from the one on Kasli v2.0?

filipswit, 2021-02-22:
Well, I marked mounted,  same as on Kasli 2.0.1- J20. Should it be DC jack - J26?
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

kaolpr, 2021-02-26:
That's ok, my mistake.

Closed 2021-02-26.

Thread 50 (2021-03-01):

SFP / USB Chassis connection

kaolpr, 2021-03-01:
See https://github.com/sinara-hw/meta/issues/64

Closed 2022-04-21.

Thread 51 (2021-04-21):

Si549 part numbers

pkozakiewicz, 2021-04-21:
Both BOM reports include the same Si549:

LVDS variant:
OSC1,   OSC3
--
**549CBAC000112ABG**

CMOS variant:
OSC1, OSC3
--
549CBAC000112ABG

gkasprow, 2022-04-21:
fixed variants

Closed 2022-04-21.

Thread 52 (2021-05-17):

Fan connector too close to PCB edge

kaolpr, 2021-05-17:
When fan connector is connected PCB can not be placed in the 3U crate because of too small distance from the PCB edge. For the prototype it can easily be solved by replacing fan connector, however for batch production it would be more efficient to move connector a bit towards the PCB center.

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

sbourdeauducq, 2022-01-27:
Also the fan polarity is wrong.

gkasprow, 2022-01-27:
there is no single standard of fan pinout :)

sbourdeauducq, 2022-01-27:
Even with the same P/N from Radiant heatsinks?
The picture above also shows the wrong polarity; the red wire should be facing towards the back of the card.

gkasprow, 2022-01-27:
oh, you are right.

Thread 53 (2021-05-28):

Ethernet PHY reset may need to be asserted during power up

sbourdeauducq, 2021-05-28:
The Zynq cannot do it. Not sure if another reset after power-up is sufficient. Currently (without any reset) Ethernet communications work but not MDIO.
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

sbourdeauducq, 2021-05-28:
On the ZC706 (with a similar but not identical PHY) they have a gate to generate the power-up reset, so this could be important.
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

sbourdeauducq, 2021-05-29:
corresponding firmware issue: https://git.m-labs.hk/M-Labs/zynq-rs/issues/78

sbourdeauducq, 2021-07-05:
Having or not having a power-up reset does not seem to make a difference, PHY works in both cases.
Tested by @TopQuark12

TopQuark12, 2021-07-05:
Current hardware configuration works fine as is, holding rst down during power on does not affect the behavior of the phy chip in observation. Would be helpful if the schematics indicate the PHY MDIO address is 0.

gkasprow, 2022-04-21:
added note

Closed 2022-04-21.

Thread 55 (2021-05-29):

master issue: Kasli-SoC v1.0 testing

sbourdeauducq, 2021-05-29:
This Issue will be edited to reflect the current status of the v1.0 hardware functional testing.

* internal JTAG: OK
* nasty Zynq programming signals (POR and SRST): OK, needs jumpers (#54)
* external JTAG: OK (tested with Digilent HS2)
* UART: OK
* SDRAM: OK
* SD card access from firmware: OK
* SD card boot: OK
* I2C: does not work, https://git.m-labs.hk/M-Labs/artiq-zynq/issues/130
* Ethernet: data OK, MDIO does not work (#53 / https://git.m-labs.hk/M-Labs/zynq-rs/issues/78)
* WRPLL: cannot test, Si549 not available
* EEM slots: not tested
* SFPs: not tested
* Fan control: not tested
* External clock input: not tested
* LEDs: ERROR LED OK, others not tested

sbourdeauducq, 2021-05-30:
Built a system with Kasli-SoC + 12 DIO cards in output mode, and ran artiq_sinara_tester to test EEM slots. All passed.
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

sbourdeauducq, 2021-06-19:
Excessive voltage on the T21 gate is holding the IC14/IC15 RESET asserted.
I2C waveforms on I2C_SW_1V8 and 3V3 are otherwise looking ok.

sbourdeauducq, 2021-06-19:
The voltage is around 800mV and those MOSFETs have a particularly low threshold (400mV). It seems the pulldown R33 is not sufficient to compensate for the leakage current through the unconfigured Zynq MIO pin.

sbourdeauducq, 2021-06-19:
This can be fixed in firmware by simply configuring the MIO pin:
```
          slcr.mio_pin_33.write(
                slcr::MioPin33::zeroed()
                    .l3_sel(0b000)
                    .io_type(slcr::IoBufferType::Lvcmos33)
                    .pullup(false)
                    .disable_rcvr(true)
            );
```
It will break the FTDI direct I2C access on the other hand.

But the I2C switches are still not responding even though RESET is now deasserted.

sbourdeauducq, 2021-06-19:
NACK on 0x70 is due to a software bug (SCL/SDA race).
0x71 continues to NACK for unknown reasons.

sbourdeauducq, 2021-06-19:
Probing the 3V3 I2C bus.

Writing to IC14, which works:
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

Writing to IC15, which does not:
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

gkasprow, 2021-06-21:
Xilinx FPGAs have a PUDC pin that defines pullups bahaviour. I don't know if this affects MIO pins as well

sbourdeauducq, 2021-07-05:
PHY MDIO working, was essentially a software problem (found by @TopQuark12)

gkasprow, 2022-04-21:
nothing to do here, closing

Thread 57 (2021-06-20):

I2C switch IC15 not working

sbourdeauducq, 2021-06-20:
https://github.com/sinara-hw/Kasli-SOC/issues/55#issuecomment-864394549

Tried scanning all I2C addresses (using the Rust firmware), only 0x70 answers.

sbourdeauducq, 2021-06-24:
With PyFTDI I cannot get *any* address to answer, but maybe I'm using it wrong.

sbourdeauducq, 2021-06-29:
Seems IC15 was simply dead and there's no design problem.

Closed 2021-06-29.

Thread 59 (2021-08-31):

Stock problems

pkozakiewicz, 2021-08-31:
I would like to address numerous stock problems regarding this project:

NC7WZ07P6X
TPS7A7200RGW
TPS7A7100RGW
88E1512-XX-NNP2I000
DSC1001DI5-025.0000T
7M-12.000MAAJ-T

I would like to create a clear list of alternatives that could be placed instead.
@gkasprow could you please help?

Programmable oscillators and FPGAs are also unavailable at the moment, but there's nothing that we can replace them with.

gkasprow, 2021-08-31:
Was the PCB produced already?

gkasprow, 2021-08-31:
NC7WZ07P6X -> SN74LVC2G07DCKR;
TPS7A7200RGW needs PCB changes
TPS7A7100RGW needs PCB changes
88E1512-XX-NNP2I000 -> any 88E1512 would work with same package
DSC1001DI5-025.0000T -> any 2*2.5 1.8V 25MHz 15ppm oscillator, any of [them ](https://pl.mouser.com/Passive-Components/Frequency-Control-Timing-Devices/Oscillators/_/N-7jdfiZ1yzvvqx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)should work; use TG2520SMN 25.0000M-ECGNNM3 or ASD3-25.000MHZ-LR-T
7M-12.000MAAJ-T -> any 3.2x2.5, 4 pin, 12MHz, <50ppm, 18pf crystal would work; ABM8-12.000MHZ-R100-D7G-T, ECS-120-18-33-AGN-TR,830069944

pkozakiewicz, 2021-09-01:
> Was the PCB produced already?

Yes, but we can consider rejecting it or using it later. I guess that placing double footprints wherever possible would be a good practice. AFAIK the market situation is unlikely to improve by the end of 2022.

pkozakiewicz, 2021-09-01:
> TPS7A7200RGW needs PCB changes
> TPS7A7100RGW needs PCB changes

These are available, but their current price is much higher than PCB tooling and manufacturing cost.

Closed 2022-04-21.

Thread 60 (2021-09-03):

Typo: incorrect MPN and description for Zynq-7000

HarryMakes, 2021-09-03:
Hi, I'd like to report a minor discrepancy. I found that the BOM shows a minor typo on the row for the Zynq-7000 chip:

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

The correct P/N is XC7Z030-3FFG67**6**E, but the "manufacturer part number" shows "XC7Z030-3FFG67E" (with only one '6') instead.

The "description" too is different, which seems to refer to the old speed grade (2) and/or temperature range (I).

As shown on the Altium PCBDOC (using the [online viewer](https://www.altium.com/viewer/)), the typo also exists on the design file. Additionally the "device" parameter matches the outdated "description", but this doesn't affect the BOM.

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

Other parameters such as "part number" are mostly correct. Thank you.

filipswit, 2022-06-10:
Fixed in v1.0.1

Closed 2022-06-10.

Thread 61 (2021-11-11):

Track width inconsistency: EXT7.LVDS_4_P/N

HarryMakes, 2021-11-11:
As of v1.0rc4 (63c775d470cd07b5cd207c0621ebe2929be7f9b5), some inconsistency in the impedance-controlled tracks has been observed (NB this list might be expanded with further investigation):

* **EXT7.LVDS_4_P/N**, 100 ohm diff pair:
  * On **TOP** layer, all other EXT*.LVDS_*_P/N tracks are 0.081 mm wide with 0.15 mm spacing. However, this track is **0.1 mm** wide with the same spacing.

gkasprow, 2022-04-21:
fixed rules in v1.0.1

Thread 62 (2021-12-16):

IC40 label overlaps the copper pad

HarryMakes, 2021-12-16:
We found that on the bottom layer, the label for IC40 on the bottom layer overlay is overlapping the copper pad for the heatsink.

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

gkasprow, 2021-12-16:
It looks like there is a rule missing or disabled

HarryMakes, 2021-12-16:
CC @sbourdeauducq

gkasprow, 2022-04-21:
fixed

Closed 2022-04-21.

Thread 63 (2021-12-16):

Question about drill holes for the front panel

HarryMakes, 2021-12-16:
We found that the drill holes for assembling the front panel look inconsistent with other Sinara PCBs in the following ways:

#### Kasli-SoC v1.0rc4
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
#### IDC-SMA v1.0rc1
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

1. The copper pad for each hole has an outer diameter of 2.81 mm. However, it is 5.00 mm on other PCBs such as Urukul and IDC-SMA.
2. The solder mask on these locations has the same diameter of 2.81 mm. However, it is 5.12 mm on other PCBs, which is slightly larger than the copper pad.
3. Using the Altium online viewer, the distance (presumably from centre to centre) between the two holes is 87.63 mm on Kasli-SoC. However, it is 83.90 mm on other PCBs.

For (1), is it an error that the copper pad is almost identically-sized as the drill hole (2.8 mm in diameter)?

For (2), does it matter for the solder mask to be slightly bigger than the copper pad around each of these holes? Can they be of the exact same diameter as the copper pad, i.e. 5.00 mm?

For (3), has the distance changed for Kasli-SoC? On Altium it seems that the "component" for these holes are different from other PCBs - on other PCBs they are known as B1 and B2 "plated holes", but on Kasli-SoC they don't have designators. On other PCBs they are usually connected to GND but not on Kasli-SoC. With the current Kasli-SoC v1.0rc4 drilling data, will the normal 3U 8HP front panel not fit on the PCB?

Thank you!

HarryMakes, 2021-12-16:
CC @sbourdeauducq

gkasprow, 2021-12-16:
This looks like a question from the PCB house. So you are actually making the Sinara HW in China/TW...
The Sinara community should be aware of this.

gkasprow, 2022-04-21:
fixed in v1.0.1

Closed 2022-04-21.

Thread 65 (2022-02-01):

v1.1

jordens, 2022-02-01:
@gkasprow @sbourdeauducq @hartytp and whoever else is interested

I'm not fully aware of what the current state of Kasli-SoC is beyond what I can tell from the repositories. We are being asked regularly what the status and are mostly recommending that people wait or get involved actively. Two things:

* Is Kasli-SoC being used somewhere actively and more or less continuously or is everybody waiting for somebody else to go through the v1.0 hardware pain phase?
* Does it make sense to address the current HW issues in a v1.1 now (or is it good enough/not enough issues to bother)?

hartytp, 2022-02-01:
Been trying to get our hands on one for a very very long time, but the ship date from CTI keeps slipping...

gkasprow, 2022-02-01:
Yes, the lead time of many ICs is a serious issue. These days I don't even start a new project before making sure all ICs arrived.

jordens, 2022-02-01:
@pkozakiewicz apparently has the parts and could make some, waiting for a decision regarding v1.0 vs v1.1 boards.
We are in the queue for a couple but happy to reduce if someone wants to forge ahead.

gkasprow, 2022-02-01:
I'd suggest fixing only minor issues for the moment. I can assign a dedicated engineer in 6 weeks who would implement all changes.

dhslichter, 2022-02-01:
@jordens for those interested in a Zynq core device with Sinara hardware on a shorter timescale, one option is to use ZC706 as a DRTIO root node and then connect to satellite Kasli(s) in Sinara crate(s) via optical fiber. NIST has funded DRTIO master/satellite for ZC706 and KC705, and we are debugging ZC706 master/Kasli satellite on the magtrap setup at present.

jordens, 2022-02-01:
I am aware but not interested in the ZC706. This is about Kasli-SoC.

hartytp, 2022-02-01:
@cjbe will know the details better than me, but IIRC we ordered a pretty large batch from CTI a while ago and don't plan to order more until testing has been done. CTI are still having stock issues (even if TS have some).

sbourdeauducq, 2022-02-02:
No major issues in v1.0 from what I can tell, only what I reported.

pkozakiewicz, 2022-02-03:
@jordens I have one board left that was produced for our internal use. We have finished our work with it. Would you need it for hands-on experience before confirming production of the current release?

pkozakiewicz, 2022-02-09:
What is the final decision on this topic? Shall we wait for v1.1 or produce v1.0 immediately?

gkasprow, 2022-02-11:
@pkozakiewicz Produce v1.0 but make R33=2k2

pkozakiewicz, 2022-02-14:
@gkasprow @jordens @sbourdeauducq @hartytp Good, we are starting production.

gkasprow, 2022-04-21:
fixed in v1.0.1

Closed 2022-04-21.

Thread 67 (2022-06-10):

mechanical issues v1.0.1

filipswit, 2022-06-10:
- [ ] LD7 should be changed to thinner one. During panel assembly maybe damaged

filipswit, 2022-11-15:
HSMC-C110 changed to HSMC-C120

Closed 2022-11-15.

Thread 68 (2022-07-26):

LDO instable - input capacitance to low

mkiepiela, 2022-07-26:
Input capacitance at IC35 is too low (only C125 = 1 uF). It causes voltage instability both, at the output (1V0) and input (1V8) side. As an effect MGTs transceivers may not work correctly.

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

After adding 2.2 uF capacitor in parallel to C125, supply voltage is correct and MGTs work well.
Basically, all LDOs should be reviewed, as there are more LDOs with 1 uF input capacitance. Probably some of them also should be increased.

gkasprow, 2022-07-26:
Good catch.
Moreover, take into account C=f(V) effect in ceramic capacitors. Real capacitance is often twice lower than rated.

nkrackow, 2022-08-02:
So I think the other affected caps are C118, C113 and C130? Or are there more at other places that I might have missed?

mkiepiela, 2022-08-03:
Yes, it looks like there are only these 3 caps more as you pointed above. However I looked into datasheet of LDO and it suggests using 1 uF input cap in combination with low line impedance.

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

So far we encountered the problem only with 1V0 LDO when MGT transceivers were active (high current consumption from 1V0 domain). Other voltages were stable and did not need additional capacitance.
Moreover, there is the least dropout value on this particular LDO (1V8 - 1V0 = 800 mV) what increases the risk of instability.

The next one with low dropout value (1.35 V) is IC33 (1V35 VCCDDR), however we did not observe instability there. But for now we were able to check it only on one board.

Summarizing, I think that adding capacitor only at 1V0 LDO seems to be a good enough solution, unless someone observe similar problem on any other LDO.

nkrackow, 2022-08-03:
Ok, thanks!

filipswit, 2022-11-15:
Added 10uF at inputs for all 4 LDOs

Thread 69 (2022-11-15):

changelog v1.0.2

filipswit, 2022-11-15:
- [ ] fixed https://github.com/sinara-hw/Kasli-SOC/issues/68
- [ ] fixed https://github.com/sinara-hw/Kasli-SOC/issues/67
- [ ] added 24AA025E48T-I/OT and  24AA025E48-I/SN on separate I2C bus https://github.com/sinara-hw/Kasli-SOC/issues/66
- [ ] added jumpers to BoM https://github.com/sinara-hw/Kasli-SOC/issues/54
- [ ] Added alternate LDOs - TPS74901RGWT
- [ ] Added alternate GPIO expanders - PCA9539APW

gkasprow, 2022-11-23:
@filipswit did you consult moving the EEPROMs to separate I2C interface with software guys?

filipswit, 2022-11-23:
no, but default EEPROM, IC5 is not moved.
We can't add aditional footprint - https://github.com/sinara-hw/Kasli/issues/97, because of conflict with SFP3 addres, so I made same solution as in Kasli v2.0.2

kaolpr, 2022-11-23:
I believe there was some discussion on version naming convention and patch number (according to <major>.<minor>.<patch>) was to be reserved only for compatible component replacements. Here I can see some issue fixes.

If such discussion was not written (honestly, don't remember) maybe we should write down rules on that.

filipswit, 2022-11-23:
@gkasprow and @kaolpr so should I rename it to v1.1?

gkasprow, 2022-11-23:
yes, since it requires software changes, there must be new revision

gkasprow, 2022-11-23:
The R110 and R100 could be replaced with E24 values
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

kaolpr, 2022-11-23:
> yes, since it requires software changes, there must be new revision

@gkasprow How does it require software changes? IO expander has different address / registry map?

gkasprow, 2022-11-23:
Before EEPROM was connected to shared bus, now it has a dedicated FPGA pins.

gkasprow, 2022-11-23:
@filipswit there is yet another [issue ](https://github.com/sinara-hw/EEM_FMC_Carrier/issues/46#issuecomment-1317083831)that needs correction
The MCP23017 expander port 7 must be output. So we need to swap DISABLE with FAULT
I'd add a reistors for revision ID like in Kasli + one resistor for variant ID (a kind of expanders assembled) placed on the same sheet as I2C expanders

filipswit, 2022-11-23:
>  decouple it from LDOs 1uF caps with a few tens Ohm resistor

You mean to place resistor (22R?) in series with 1uF at all LDOs Vbias inputs?
BTW. I can place any different LDO if you have any other cheap and small.

> The MCP23017 expander port 7 must be output. So we need to swap DISABLE with FAULT
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

So it looks that IC24 is fine (these are test points) and in IC25 I should swap 'VUSB_PRESENT_N', with 'SFP_0.LED'?
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
> I'd` add a reistors for revision ID like in Kasli + one resistor for variant ID (a kind of expanders assembled) placed on the same sheet as I2C expanders

I'll try to fit 3-4 rev ID bits and one variant ID resistor

gkasprow, 2022-11-23:
> > decouple it from LDOs 1uF caps with a few tens Ohm resistor
>
> You mean to place resistor (22R?) in series with 1uF at all LDOs Vbias inputs? BTW. I can place any different LDO if you have any other cheap and small.

just add a single 22Ohm (or similar already in the BOM) at the LDO output after the 100nF cap.

gkasprow, 2022-11-23:
> So it looks that IC24 is fine (these are test points) and in IC25 I should swap 'VUSB_PRESENT_N', with 'SFP_0.LED'?

yep, my bad

filipswit, 2022-11-23:
Just verified the DS for this LDO, so it looks 470nF is absolute minimum i this case:
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

Would it be good enough solution?
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

gkasprow, 2022-11-23:
OK, so you found better DS than me :)

gkasprow, 2022-11-23:
No need for series resistor then.

filipswit, 2022-11-24:
@gkasprow could you please look at the changes one more time?

kaolpr, 2022-12-27:
@gkasprow @filipswit  Can we assume v1.1 is reviewed?

kaolpr, 2022-12-27:
@gkasprow Do you think https://github.com/sinara-hw/Kasli/issues/99 should be implemneted here?

gkasprow, 2022-12-30:
SOT-23 version of EEPROM is still not available

gkasprow, 2022-12-30:
please add note close to the I2C expanders that ASSY variant need to be updated.

gkasprow, 2022-12-30:
why both EEPROMs are not mounted?
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

gkasprow, 2022-12-30:
Ah, I see, IC5 is connected instead...
I'd add 24AA025E48T-I/OT assembly variant to it as well.

filipswit, 2022-12-31:
yeep, it should be added. I've made issue to not forget about it in next revision https://github.com/sinara-hw/Kasli-SOC/issues/72.

Thread 70 (2022-11-23):

revision ID and variant ID

gkasprow, 2022-11-23:
@filipswit please add REV_ID signals as in Stabilizer/Phaser/Thermostat
set revID = 1 because we have  1.1 PCB
make rev ID 4 bits
you can use any FPGA pins, could be in different banks
place the variant ID close to the I2C expanders.
The firmware must know which expanders are assembled. One can theoretically detect them looking at their address but having a dedicated pin is easier.
Here is how revision/variant ID is implemented in Phaser
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

filipswit, 2022-11-23:
Added:
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

Closed 2022-11-24.

Thread 71 (2022-12-15):

replace tantalum caps with ceramic + resistor

dhslichter, 2022-12-15:
See https://github.com/sinara-hw/Kasli/issues/99

Involves replacing C295 at a minimum.

Thread 72 (2022-12-31):

Add another EEPROM to SHARED_I2C

filipswit, 2022-12-31:
I'd add 24AA025E48T-I/OT assembly variant to it as well.

_Originally posted by @gkasprow in https://github.com/sinara-hw/Kasli-SOC/issues/69#issuecomment-1368025686_

maciejprzybysz, 2023-03-02:
@filipswit
Could you please explain why do we need both IC5 and IC45 on board? When 24AA025E48-I/SN is not available you put IC44 on board. You need different I2C bus due to address conflict on SHARED_I2C, right? But what is the default approach when you have 24AA025E48-I/SN EEPROM? Do you mount IC5 or IC45? Have you consulted this with someone from software?

Thread 73 (2023-03-02):

Changelog v1.1.1

maciejprzybysz, 2023-03-02:
Minor changes:
- [x] TOP level schematic document has invalid version number (v1.0)
- [x] Unnecessary "NO ERC" directive on Kasli-SOC_QUAD_BUCK.SchDoc X:50mil Y:6500mil
- [x] J25 is moved away from the board edge in v1.1 - no change in v1.1.1, just noticed here (no issue nor changelog about that found)
- [x] Validation errors/warnings corrected
- [x] IC4 hidden GND pin
- [x] synchronize ports and sheet entries on Kasli-SOC_top.SchDoc sheet symbols (harness types)
- [x] DRC errors (no net via + poly top/bot)
- [x] Changed version number on panel (was v1.0)

Thread 74 (2023-05-08):

Undefined behavior with SPI devices on several EEM ports

thomasfire, 2023-05-08:
We've been struggling with the [issue](https://git.m-labs.hk/M-Labs/artiq-zynq/issues/197) that EEM ports 2-7 and 10-11 often fail to work with Samplers, Zotinos, Mirnies and probably some others.
It appears that these ports are LVDS_18 and not LVDS_25, which are used in RISCV Kasli and other ports on Kasli-SoC. Which leads to the devices fail to recognize the signal because it may be lower than a threshold. Also it seems to be a limitation on Zynq chips https://docs.xilinx.com/v/u/en-US/ug475_7Series_Pkg_Pinout .

Are there any solutions or workarounds about this?

gkasprow, 2023-05-08:
You cannot use LVDS_18 with 2.5V supply on Kasli.
Artix devices support LVDS only on 2.5V ports.
1.8V LVDS ports are supported only in KIntex HP banks.
Kasli SoC banks 12,13 use 2.5V and LVDS25 because these are HR banks
banks 33,34,35 use 1.8V and LVDS18 because these are HP banks

thomasfire, 2023-05-09:
Are there any workarounds/fixes possible? It is quite annoying problem for us

gkasprow, 2023-05-09:
Just use right primitives dedicated to bank types. It is not a bug

gkasprow, 2023-05-30:
I might have an idea of what is going on.
Don't these modules use the same LVDS drivers?
When working with Sayma, I noticed the strange behaviour of 3.3V LVDS transceivers when working with 1.8V banks.
The FPGA bank voltage was elevated to over 2V instead of 1.8V, which was caused by abnormal LVDS transceiver behaviour.
The LVDS transceiver sometimes produced a 3V level on the differential pair when inactive.
When active, the level was around 1.2V which is the desired level for LVDS.

Closed 2023-06-02.

Thread 75 (2023-07-19):

EEM8 and EEM9 collide with rails

jordens, 2023-07-19:
EEM8/9 have a small clearance of ~1.5 mm to the board edge. In common board storage systems or crates with 3 mm rail depth this isn't enough and leads to seizing/scratching/damage. If possible move them 0.5 mm, better 1 mm, down. Same for the fan connector if not already done.

kaolpr, 2023-07-20:
Has this issue been previously reported? If not, its severity may be questionable since it has gone unreported for over three years.

Currently, implementing this modification would impede the adoption process of DIOT, as a number of adapters have already been manufactured specifically for this EEM layout.

We can leave this open and if any other layout-altering issues emerge, we can address them in a future release that may require a new version of EEM adapters.

jordens, 2023-07-20:
As stated, it's not an issue in many crates as the rails aren't that deep and there is usually no other rail so close. But in PCB storage systems there is always a rail adjacent.
I don't see how this really hinders DIOT adoption. People will know whether they need the adapter when they order Kasli. Hence there is little desynchronization. Just make a revision in both designs and match the releases/production.
As mentioned previously, also for exactly these reasons I'd rather deprecate this adapter and make a proper Kasli-DIOT. The adapter road especially on Kasli is IMO the biggest blocker in DIOT adoption in Sinara.

linuswck, 2025-06-04:
> EEM8/9 have a small clearance of ~1.5 mm to the board edge. In common board storage systems or crates with 3 mm rail depth this isn't enough and leads to seizing/scratching/damage. If possible move them 0.5 mm, better 1 mm, down. Same for the fan connector if not already done.

To increase the components clearance from board edge, it also requires the FPGA_JTAG connector and some other components to be moved downwards as well. However, there is no physical space to move FPGA_JTAG connector downward. I don't think it can be done without moving and re-routing components around. See the screenshot below.
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

jordens, 2025-06-05:
Best effort would already go a long way. If you can at least move the EEM connectors that would already be a big improvement.

linuswck, 2025-06-05:
I can only move the EEM8/9 connector downward by 1mm. That is what I will do in the new revision #86.

The fan connector cannot be moved downward due to lack of physical space for the SFP high speed signal.
See screenshots below
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

jordens, 2025-06-06:
You can move it down and left if you rotate it.

jordens, 2025-06-06:
You can also ignore the mounting hole. The only user that I am aware of is the diot adapter which is clearly already moot.

linuswck, 2025-06-06:
@martafafara should I ignore that mounting hole?

martafafara, 2025-06-06:
I'm currently checking all changes, give me some time to consider that

martafafara, 2025-06-06:
I've done the placement study of some solutions and consulted with @kaolpr. The summary is that this mounting hole can be neglected. If we move the EEM connectors down, then the DIOT adapter have to be redesigned and its mounting hole could be also changed. Moreover, this particular mounting point has not been used in any known cases.
It would require some time, but I found feasible to move also C161 and L18. It could be a big improvement.

martafafara, 2025-06-12:
Yes, remove it, please.

Thread 76 (2023-10-11):

DIOT(CPCI) version of Kasli SOC

gkasprow, 2023-10-11:

jordens, 2023-10-11:
Let's do this.
Could you propose a rough block diagram or schematic sketch that we can iterate on?
Is there no OHWR/CERN DIOT system board with a SoC that we could align with?

marmeladapk, 2023-10-11:
We'll probably take a lot from DIOT System Board (
https://ohwr.org/project/diot-sb-zu/).

śr., 11 paź 2023, 23:12 użytkownik Robert Jördens ***@***.***>
napisał:

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

gkasprow, 2023-10-12:
We will only replace EEM connectors with CPCIS ones and use bigger FPGA. Rest remains the same.
An important feature is correct power sequencing that should improve Kasli's survivability.

jordens, 2023-10-26:
Having reviewed the DIOT sys board it looks like we can take it as is.

jordens, 2023-11-08:
... especially if the planned changes for v3 land (RJ45 to PS, USB for JTAG/I2C etc).

Thread 77 (2023-10-13):

ftdi serial number

jbqubit, 2023-10-13:
The USB-serial interface chip is a FT4232H QUAD HIGH SPEED USB TO MULTIPURPOSE UART. This chip is accompanied by an EEPROM on Kasli-SOC. FTDI supports assignment of a factory-defined serial number to the chip which stored on the EEPROM. This is set using the FTDI tool [FT_PROG](https://ftdichip.com/utilities/).

My Kasli-SOC shipped from Technosystem with no flashed serial number. This is problematic because Kasli-SOC can't be deterministically identified in a system without it.

```
$ python3 -m serial.tools.list_ports -v
/dev/ttyS0  
    desc: ttyS0
    hwid: PNP0501
/dev/ttyUSB3
    desc: Quad RS232-HS - Quad RS232-HS
    hwid: USB VID:PID=0403:6011 LOCATION=1-14.4:1.1
/dev/ttyUSB4
    desc: Quad RS232-HS - Quad RS232-HS
    hwid: USB VID:PID=0403:6011 LOCATION=1-14.4:1.2
/dev/ttyUSB5
    desc: Quad RS232-HS - Quad RS232-HS
    hwid: USB VID:PID=0403:6011 LOCATION=1-14.4:1.3
5 ports found
```

After using FT_PROG...
```
$ python3 -m serial.tools.list_ports -v
/dev/ttyS0  
    desc: ttyS0
    hwid: PNP0501
/dev/ttyUSB0
    desc: FT232R USB UART - FT232R USB UART
    hwid: USB VID:PID=0403:6001 SER=AL02CA9T LOCATION=1-14.3.1
/dev/ttyUSB1
    desc: USB-serial - USB-serial
    hwid: USB VID:PID=0403:6011 SER=umd-ksoc-001 LOCATION=1-14.4:1.0
/dev/ttyUSB2
    desc: USB-serial - USB-serial
    hwid: USB VID:PID=0403:6011 SER=umd-ksoc-001 LOCATION=1-14.4:1.1
/dev/ttyUSB3
    desc: USB-serial - USB-serial
    hwid: USB VID:PID=0403:6011 SER=umd-ksoc-001 LOCATION=1-14.4:1.2
/dev/ttyUSB4
    desc: USB-serial - USB-serial
    hwid: USB VID:PID=0403:6011 SER=umd-ksoc-001 LOCATION=1-14.4:1.3
6 ports found
```

Please add EEPROM s/n programming to the Kasli-SOC factory test suite.

jbqubit, 2023-10-13:
Also, the Product Description field on the EEPROM is a generic "Quad RS232-HS". This could be something more descriptive such as "sinara kasli-soc". This would make it easier for users to identify the board and would require a trivial change to the openocd script ```kasli_soc.cfg```.

marmeladapk, 2023-10-13:
AFAICT CTI does this, Quartiq and M-labs probably as well with https://github.com/quartiq/kasli-i2c . Please direct this to manufacturers directly, as there's nothing to do in this PCB project.

Also changing name would break compatibility of openocd with older boards, but you can discuss this in m-labs fork of openocd or in artiq repository.

jbqubit, 2023-10-16:
In case somebody looks at this Issue in the future I'll summarize. [Most ARTIQ infrastructure](https://git.m-labs.hk/M-Labs/zynq-rs/src/commit/c15b54f92b3d4e125ae47a0dce7abe4b2bc9e054/openocd/kasli_soc.cfg) assumes that Kasli boards have the ```ftdi_device_desc``` field stuffed with ```Quad RS232-HS```. Unique identification requires that the each Kasli SOC have a unique serial number -- the [FT_PROG](https://ftdichip.com/utilities/) tool can do this automatically.

Closed 2023-10-13.

Thread 78 (2023-10-27):

bootloader switch

gkasprow, 2023-10-27:
https://github.com/sinara-hw/Kasli/issues/107

Thread 80 (2024-04-26):

Add P12V0 switch for EEMs

marmeladapk, 2024-04-26:
https://github.com/sinara-hw/Kasli/issues/109

marmeladapk, 2024-04-26:
And P3V3

Thread 81 (2024-06-04):

12V input short circult

IamTaoChen, 2024-06-04:
It seems that my Kasli-SOC was short circuit and the fan doesn't work.  The chip `LTM4644IY` is a little hot.

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

gkasprow, 2024-06-04:
what do you mean by "was short circuit"?
Did you short any pins?

IamTaoChen, 2024-06-05:
I'm not sure.
I wanted to install the firmware into the SD card. I didn't install it back on the rack when I powered it on,  I held the card, and maybe, the back touched something.

gkasprow, 2024-06-05:
Well, the SD slot was not designed for life insertion.
How can I help you? You should send the PCB to the manufacturer for repair then.

IamTaoChen, 2024-06-05:
I just want to know how to do a basic test to know which part is burned.

gkasprow, 2024-06-05:
critical supplies are missing so it's either SMPS or FPGA which is broken

Thread 82 (2024-11-06):

Inconsistent oscillator OE default state

kaolpr, 2024-11-06:
It looks that v1.1.1 has inconsistent power-on state for Si549 oscillators across assembly variants:

**LVDS - consistent with a note near OSC1 and OSC3**

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

**CMOS - inconsistent with a note near OSC1 and OSC3 and LVDS**

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

Closed 2025-08-28.

Thread 83 (2025-04-01):

The AC coupling caps on SFP GT lanes are unnecessary according to SFP(+) spec

MorganTL, 2025-04-01:
The [SFP+ 10 Gb/s and Low Speed Electrical Interface SFF-8431](https://members.snia.org/document/dl/25891) and [SFP (Small Formfactor Pluggable) Tansceiver  INF-8074](https://members.snia.org/document/dl/26184) mentioned the AC coupling capacitor should be on the SFP(+) module and not on the host board.

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

Thread 92 (2025-09-09):

v1.2: MCP23017 7th "ios" must be output

MorganTL, 2025-09-09:
- the EEM_FAULT_N is connected to MCP23017 7th pin which is output only
- see [efc#46](https://github.com/sinara-hw/EEM_FMC_Carrier/issues/46#issuecomment-1317083831)

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

martafafara, 2025-09-09:
v2.1rc4 in progress.

atseml, 2025-09-09:
Is there any way the schematic of the chip itself can be changed? Then a comment wouldn't be needed.

martafafara, 2025-09-22:
Introduced.

Closed 2025-09-22.
