sinara-hw/Kasli-SOC/(list of files, drawings)

Other design files:
Kasli-SOC.PrjPcb
Schematics/Kasli-SOC_bank0.SchDoc
Schematics/Kasli-SOC_bank12.SchDoc
Schematics/Kasli-SOC_bank13.SchDoc
Schematics/Kasli-SOC_bank33-34-35.SchDoc
Schematics/Kasli-SOC_bank112.SchDoc
Schematics/Kasli-SOC_bank500-501.SchDoc
Schematics/Kasli-SOC_bank502_DDR.SchDoc
Schematics/Kasli-SOC_ClockRecovery.SchDoc
Schematics/Kasli-SOC_ETH_PHY.SchDoc
Schematics/Kasli-SOC_IDC_EXT_Connectors.SchDoc
Schematics/Kasli-SOC_linear.SchDoc
Schematics/Kasli-SOC_MUX_I2C.SchDoc
Schematics/Kasli-SOC_power.SchDoc
Schematics/Kasli-SOC_PWR.SchDoc
Schematics/Kasli-SOC_QUAD_BUCK.SchDoc
Schematics/Kasli-SOC_SFP.SchDoc
Schematics/Kasli-SOC_top.SchDoc
Schematics/Kasli-SOC_USB_Serial_Quad.SchDoc
