sinara-hw/Kasli-SOC/(commit log)

2020-01-06 Repo init.
    [Kasli-SOC.PrjPcb, Kasli-SOC_ClockRecovery.SchDoc, Kasli-SOC_MUX_I2C.SchDoc, Kasli-SOC_PWR.SchDoc, Kasli-SOC_QUAD_BUCK.SchDoc, Kasli-SOC_SFP.SchDoc, Kasli-SOC_USB_Serial_Quad.SchDoc, Kasli-SOC_bank0.SchDoc]
2020-01-22 Changed Rx/Tx UART voltage to 1.8 Added VREF_DDR and VTT_DDT regulator removed IC12 P5V0_CLK-->chabged to P3V6 Added DOONE pullup removed FPGA ref. Added 0R res to TPSA7200RGW to configuration pins. 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
    [Kasli-SOC.PrjPcb, Kasli-SOC_ClockRecovery.SchDoc, Kasli-SOC_ETH_PHY.SchDoc, Kasli-SOC_IDC_EXT_Connectors.SchDoc, Kasli-SOC_MUX_I2C.SchDoc, Kasli-SOC_PWR.SchDoc, Kasli-SOC_QUAD_BUCK.SchDoc, Kasli-SOC_SFP.SchDoc]
2020-01-27 Changed J24 to PL UART #19
    [Kasli-SOC_ClockRecovery.SchDoc, Kasli-SOC_ETH_PHY.SchDoc, Kasli-SOC_QUAD_BUCK.SchDoc, Kasli-SOC_USB_Serial_Quad.SchDoc, Kasli-SOC_bank112.SchDoc, Kasli-SOC_bank13.SchDoc, Kasli-SOC_bank500-501.SchDoc, Kasli-SOC_bank502_DDR.SchDoc]
2020-02-14 Preliminary placement
    [Kasli-SOC.PrjPcb, Kasli-SOC_ClockRecovery.SchDoc, Kasli-SOC_ETH_PHY.SchDoc, Kasli-SOC_PWR.SchDoc, Kasli-SOC_QUAD_BUCK.SchDoc, Kasli-SOC_bank0.SchDoc, Kasli-SOC_bank112.SchDoc, Kasli-SOC_bank13.SchDoc]
2020-02-22 Pin swapping in EXT connectors.
    [Kasli-SOC.PrjPcb, Kasli-SOC_bank12.SchDoc, Kasli-SOC_bank13.SchDoc, Kasli-SOC_bank33-34-35.SchDoc, Kasli-SOC_bank500-501.SchDoc, Kasli-SOC_top.SchDoc]
2020-03-19 Final placement
    [Kasli-SOC.PrjPcb, Kasli-SOC_ClockRecovery.SchDoc, Kasli-SOC_PWR.SchDoc, Kasli-SOC_USB_Serial_Quad.SchDoc, Kasli-SOC_bank12.SchDoc, Kasli-SOC_bank13.SchDoc, Kasli-SOC_bank33-34-35.SchDoc, Kasli-SOC_bank35.SchDoc]
2020-03-26 Preliminary routing
    [Kasli-SOC_ClockRecovery.SchDoc]
2020-04-06 Final routing.
    [Kasli-SOC_ETH_PHY.SchDoc, Kasli-SOC_IDC_EXT_Connectors.SchDoc, Kasli-SOC_PWR.SchDoc, Kasli-SOC_QUAD_BUCK.SchDoc, Kasli-SOC_bank112.SchDoc, Kasli-SOC_bank13.SchDoc, Kasli-SOC_bank33-34-35.SchDoc, Kasli-SOC_bank500-501.SchDoc]
2020-04-12 Layout improvements.
    [Kasli-SOC.PrjPcb, Kasli-SOC_PWR.SchDoc, Kasli-SOC_bank13.SchDoc]
2020-04-13 Schematics cleanup. Added variants.
    [Kasli-SOC.PrjPcb, Kasli-SOC_ClockRecovery.SchDoc, Kasli-SOC_ETH_PHY.SchDoc, Kasli-SOC_MUX_I2C.SchDoc, Kasli-SOC_PWR.SchDoc, Kasli-SOC_QUAD_BUCK.SchDoc, Kasli-SOC_SFP.SchDoc, Kasli-SOC_USB_Serial_Quad.SchDoc]
2020-04-14 Outjob added.
    [Kasli-SOC.PrjPcb]
2020-04-15 Ready to review.
    [Kasli-SOC.PrjPcb]
2020-05-16 After GK remarks. Added SD card. Pinswapping in EXT2.
    [Kasli-SOC.PrjPcb, Kasli-SOC_ClockRecovery.SchDoc, Kasli-SOC_PWR.SchDoc, Kasli-SOC_bank33-34-35.SchDoc, Kasli-SOC_bank500-501.SchDoc]
2020-05-28 power planes changes
    [Kasli-SOC_ClockRecovery.SchDoc, Kasli-SOC_ETH_PHY.SchDoc, Kasli-SOC_IDC_EXT_Connectors.SchDoc, Kasli-SOC_MUX_I2C.SchDoc, Kasli-SOC_PWR.SchDoc, Kasli-SOC_QUAD_BUCK.SchDoc, Kasli-SOC_SFP.SchDoc, Kasli-SOC_USB_Serial_Quad.SchDoc]
2020-05-28 issue #23
    [Kasli-SOC.PrjPcb, Kasli-SOC_bank502_DDR.SchDoc]
2020-07-23 Schematics in pdf
2020-07-23 FPGA pin assigment
    [Kasli-SOC.csv]
2020-09-26 Ethernet, I2C, GPIO_INTx, some LEDs connected to PS.
    [Kasli-SOC.PrjPcb, Kasli-SOC.csv, Kasli-SOC_ClockRecovery.SchDoc, Kasli-SOC_ETH_PHY.SchDoc, Kasli-SOC_IDC_EXT_Connectors.SchDoc, Kasli-SOC_MUX_I2C.SchDoc, Kasli-SOC_PWR.SchDoc, Kasli-SOC_QUAD_BUCK.SchDoc]
2021-02-16 Fixed issues after design review.
    [Kasli-SOC.PrjPcb, Kasli-SOC_ClockRecovery.SchDoc, Kasli-SOC_MUX_I2C.SchDoc, Kasli-SOC_PWR.SchDoc, Kasli-SOC_Panel.PcbDoc, Kasli-SOC_QUAD_BUCK.SchDoc, Kasli-SOC_USB_Serial_Quad.SchDoc, Kasli-SOC_bank0.SchDoc]
2021-02-16 Changed speedgrade to -3
    [Kasli-SOC_bank0.SchDoc, Kasli-SOC_bank112.SchDoc, Kasli-SOC_bank12.SchDoc, Kasli-SOC_bank13.SchDoc, Kasli-SOC_bank33-34-35.SchDoc, Kasli-SOC_bank500-501.SchDoc, Kasli-SOC_bank502_DDR.SchDoc]
2022-12-02 v1.1rc2 - minor layout corrections
    [Kasli-SOC.PrjPcb, Kasli-SOC_linear.SchDoc]
